loopj/wii-daughterboard/kicad/wii-daughterboard.kicad_pcb

## KiCad design kicad/wii-daughterboard.kicad_pcb (2020-05-27)

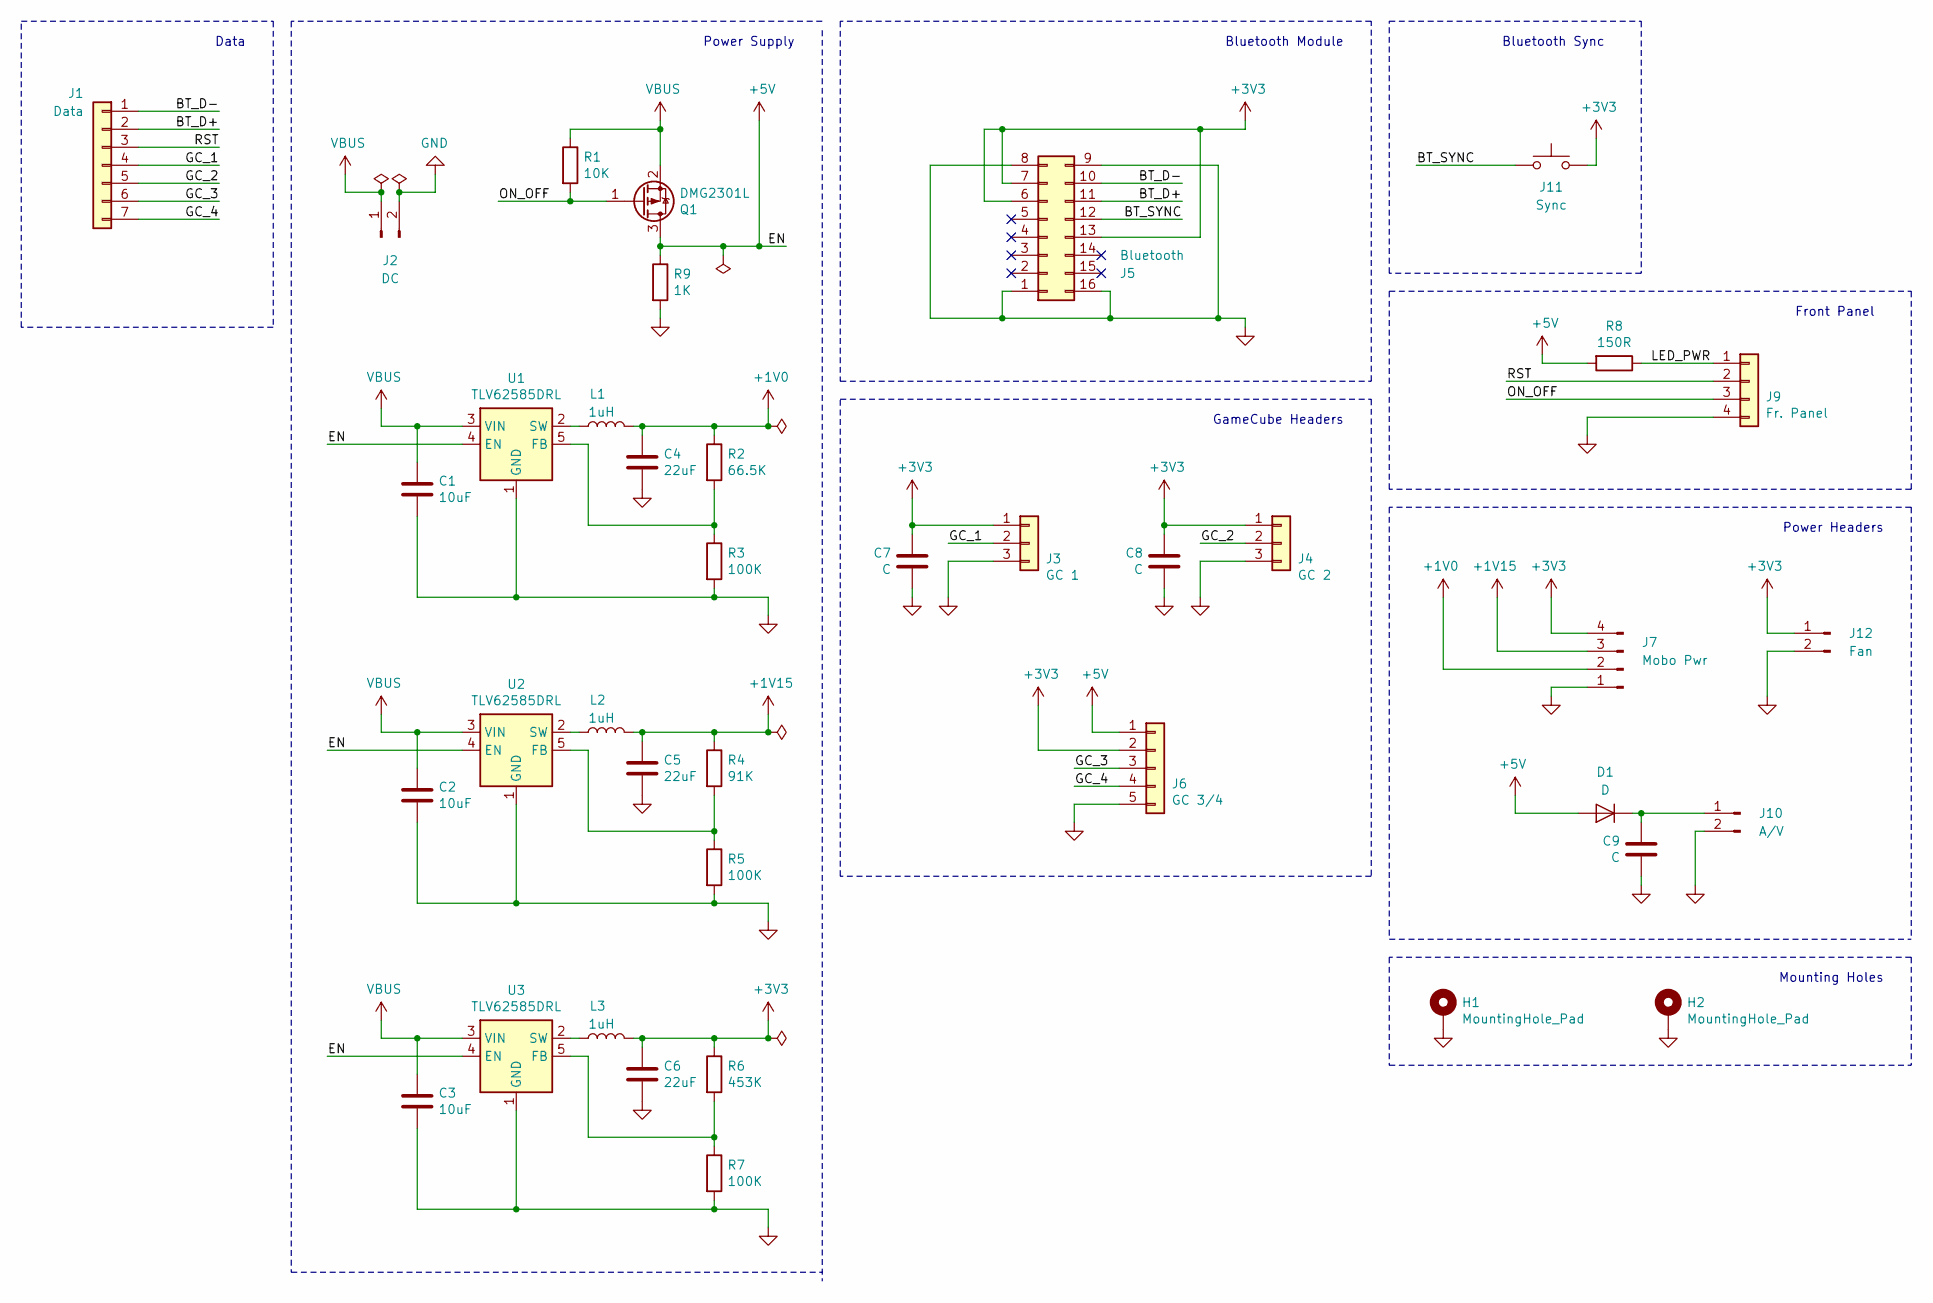
[picture p1: schematic wii-daughterboard.sch]

Parts:
C1, C2, C3: 10uF; C_0603_1608Metric_Pad1.05x0.95mm_HandSolder
C4, C5, C6: 22uF; C_0603_1608Metric_Pad1.05x0.95mm_HandSolder
C7, C8, C9: C; C_0603_1608Metric_Pad1.05x0.95mm_HandSolder
D1: D; D_SOD-123
H1, H2: MountingHole_Pad; MountingHole_2.7mm_Pad
J1: Data; JST_SH_BM07B-SRSS-TB_1x07-1MP_P1.00mm_Vertical
J2: DC; JST_PH_B2B-PH-SM4-TB_1x02-1MP_P2.00mm_Vertical
J3: GC 1; JST_SH_BM03B-SRSS-TB_1x03-1MP_P1.00mm_Vertical
J4: GC 2; JST_SH_BM03B-SRSS-TB_1x03-1MP_P1.00mm_Vertical
J5: Bluetooth; Wii_Bluetooth_Module
J6: GC 3/4; JST_SH_BM05B-SRSS-TB_1x05-1MP_P1.00mm_Vertical
J7: Mobo Pwr; JST_PH_S4B-PH-SM4-TB_1x04-1MP_P2.00mm_Horizontal
J9: Fr. Panel; SFV4R3STBE1HLF
J10: A/V; JST_SH_BM02B-SRSS-TB_1x02-1MP_P1.00mm_Vertical
J11: Sync; JST_SH_BM02B-SRSS-TB_1x02-1MP_P1.00mm_Vertical
J12: Fan; JST_SH_BM02B-SRSS-TB_1x02-1MP_P1.00mm_Vertical
L1, L2, L3: 1uH; INDPM3630X200N
Q1: DMG2301L; SOT-23_Handsoldering
R1: 10K; R_0603_1608Metric_Pad1.05x0.95mm_HandSolder
R2: 66.5K; R_0603_1608Metric_Pad1.05x0.95mm_HandSolder
R3, R5, R7: 100K; R_0603_1608Metric_Pad1.05x0.95mm_HandSolder
R4: 91K; R_0603_1608Metric_Pad1.05x0.95mm_HandSolder
R6: 453K; R_0603_1608Metric_Pad1.05x0.95mm_HandSolder
R8: 150R; R_0603_1608Metric_Pad1.05x0.95mm_HandSolder
R9: 1K; R_0603_1608Metric_Pad1.05x0.95mm_HandSolder
U1, U2, U3: TLV62585DRL; SOT-563

Connections:
+1V0: C4.1, J7.2, L1.2, R2.1
+1V15: C5.1, J7.3, L2.2, R4.1
+3V3: C6.1, C7.2, C8.2, J3.1, J4.1, J5.6, J5.7, J5.13, J6.2, J7.4, J11.2, J12.1, L3.2, R6.1
+5V: D1.2 (A), J6.1, Q1.3 (D), R8.2, R9.1, U1.4 (EN), U2.4 (EN), U3.4 (EN)
/BT_D+: J1.2, J5.11
/BT_D-: J1.1, J5.10
/BT_SYNC: J5.12, J11.1
/GC_1: J1.4, J3.2
/GC_2: J1.5, J4.2
/GC_3: J1.6, J6.3
/GC_4: J1.7, J6.4
/LED_PWR: J9.1, R8.1
/ON_OFF: J9.3, Q1.1 (G), R1.2
/RST: J1.3, J9.2
GND: C1.2, C2.2, C3.2, C4.2, C5.2, C6.2, C7.1, C8.1, C9.1, H1.1, H2.1, J2.2, J3.3, J4.3, J5.1, J5.8, J5.9, J5.16, J6.5, J7.1, J9.4, J10.2, J12.2, R3.2, R5.2, R7.2, R9.2, U1.1 (GND), U2.1 (GND), U3.1 (GND)
unnamed: C9.2, D1.1 (K), J10.1
unnamed: L1.1, U1.2 (SW)
unnamed: L2.1, U2.2 (SW)
unnamed: L3.1, U3.2 (SW)
unnamed: R2.2, R3.1, U1.5 (FB)
unnamed: R4.2, R5.1, U2.5 (FB)
unnamed: R6.2, R7.1, U3.5 (FB)
VBUS: C1.1, C2.1, C3.1, J2.1, Q1.2 (S), R1.1, U1.3 (VIN), U2.3 (VIN), U3.3 (VIN)

Notes on the sheet:
Power Supply
Bluetooth Module
GameCube Headers
Bluetooth Sync
Data
Front Panel
Power Headers
Mounting Holes

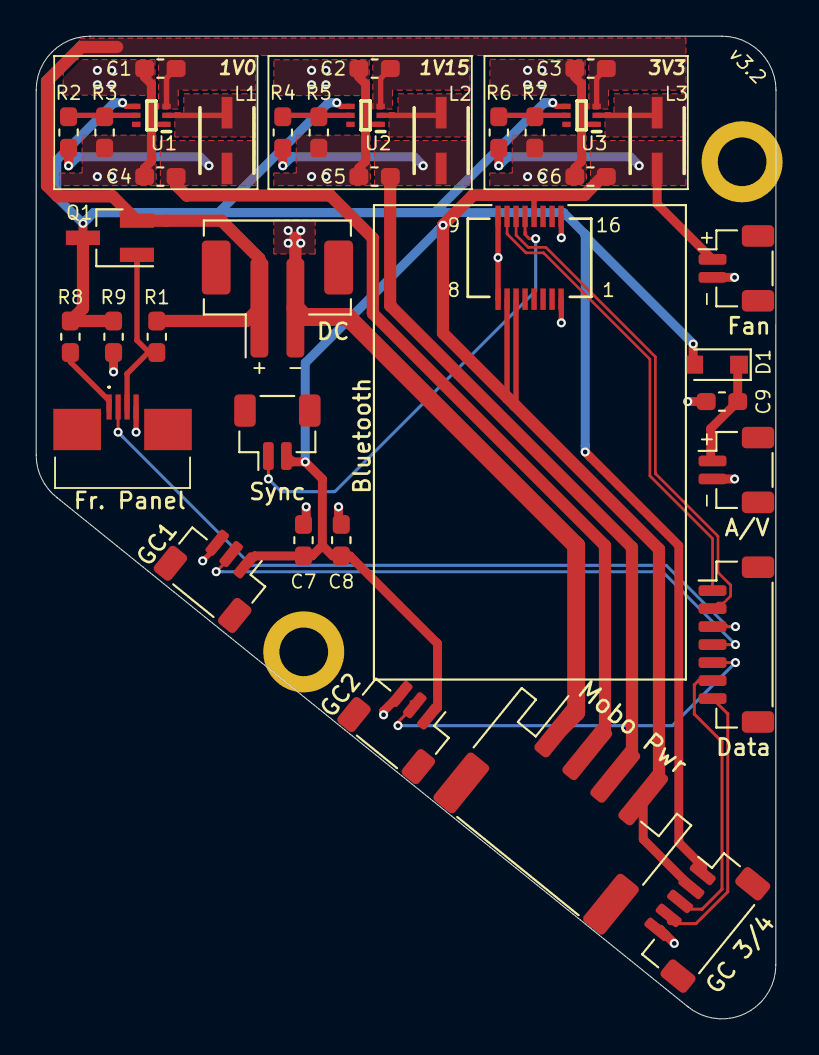
[picture p2: board wii-daughterboard.kicad_pcb from above]

Board: 2 copper layers, 41.1 x 54.6 mm, 39 parts (0 on the bottom side), 23 nets.
