loopj/wii-daughterboard/(commit log)

2020-04-30 Fix mosfet bug
    [wii-daughterboard.kicad_pcb, wii-daughterboard.sch]
2020-05-10 Fix MOSFET orientation, add pulldown
    [wii-daughterboard.sch]
2020-05-10 Change fan power to 3V3
    [wii-daughterboard.sch]
2020-05-21 Single GND return from mobo
    [wii-daughterboard.kicad_pcb]
2020-05-21 Nicer diode label
    [wii-daughterboard.kicad_pcb]
